EVR-Tuiasi/Shield_VCU_Invertoare/2.Datasheet/Sketch.jpg

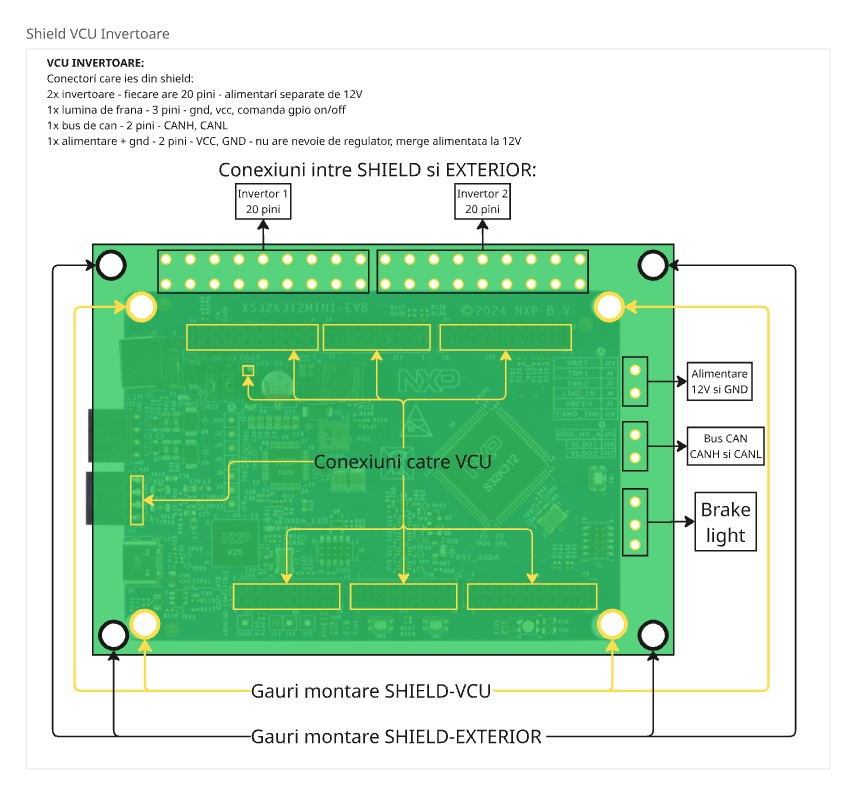
2.Datasheet/Sketch.jpg
