EVR-Tuiasi/Shield_VCU_Invertoare/2.Datasheet/Inverter/InvertorPinout.jpg

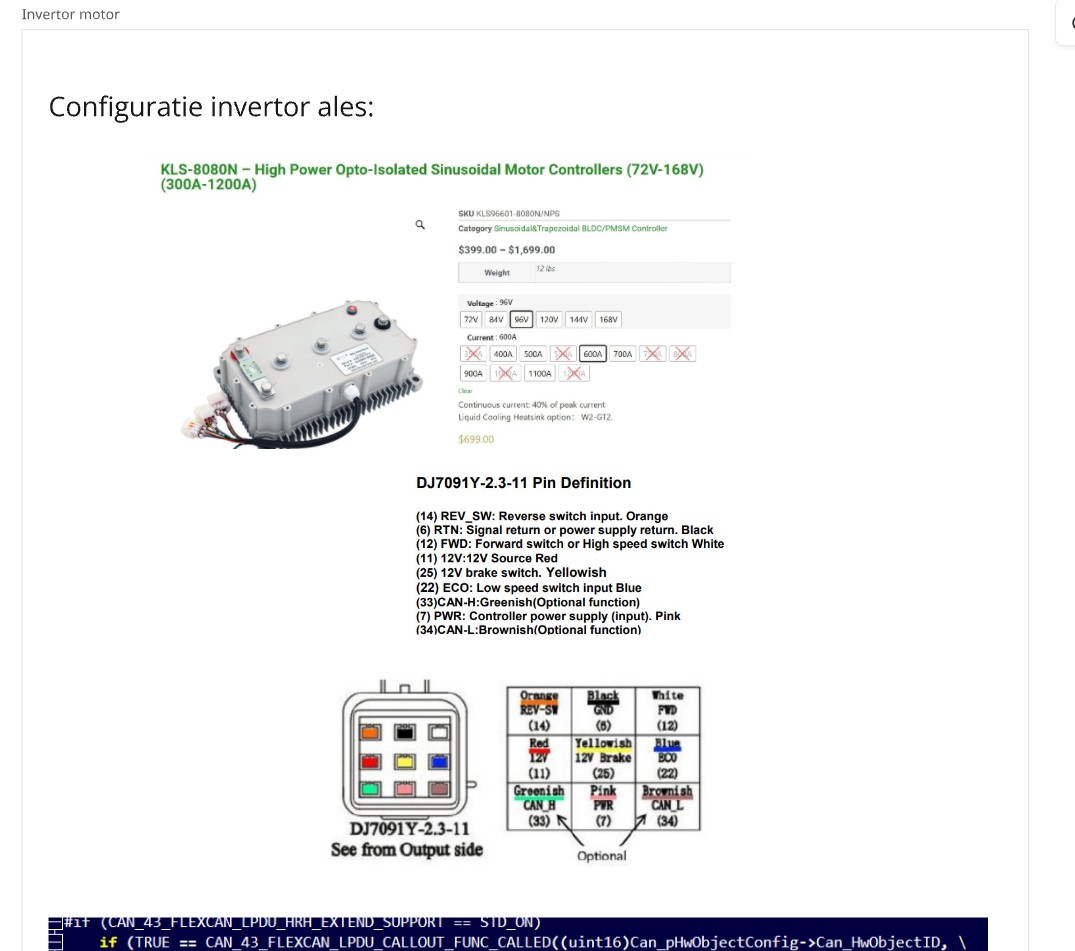
2.Datasheet/Inverter/InvertorPinout.jpg
