EVR-Tuiasi/Shield_VCU_Invertoare/4.Simulations/FAN_ctrl_HIGH.png

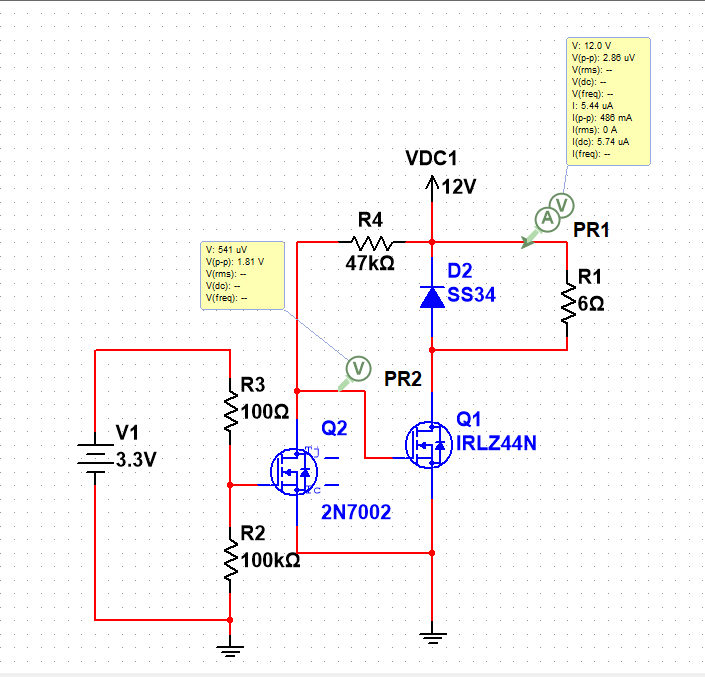
4.Simulations/FAN_ctrl_HIGH.png
