EVR-Tuiasi/Shield_VCU_Invertoare/4.Simulations/fan_cTRL_low.png

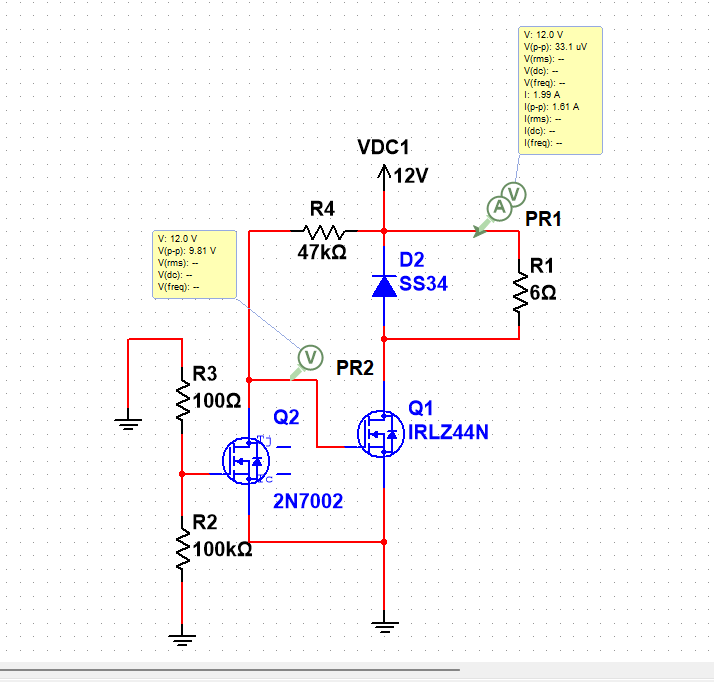
4.Simulations/fan_cTRL_low.png
