EVR-Tuiasi/Shield_VCU_Invertoare/4.Simulations/IRLZ44N_3Amp_LOAD.png

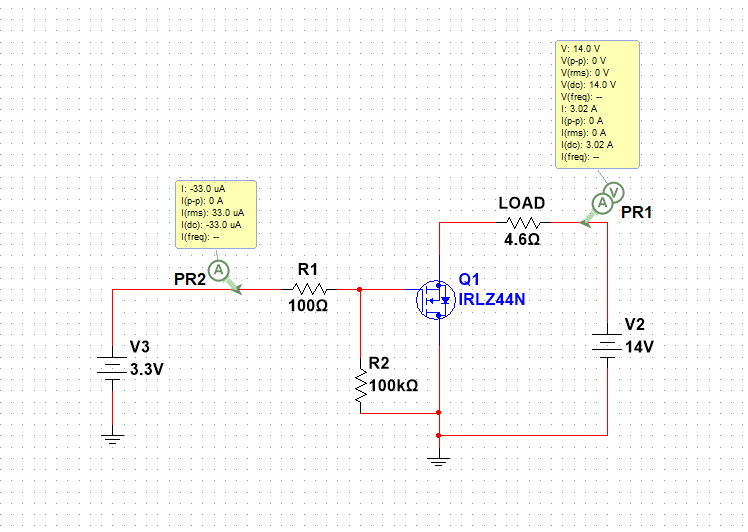
4.Simulations/IRLZ44N_3Amp_LOAD.png
