EVR-Tuiasi/Shield_VCU_Invertoare/4.Simulations/NI_relay.jpg

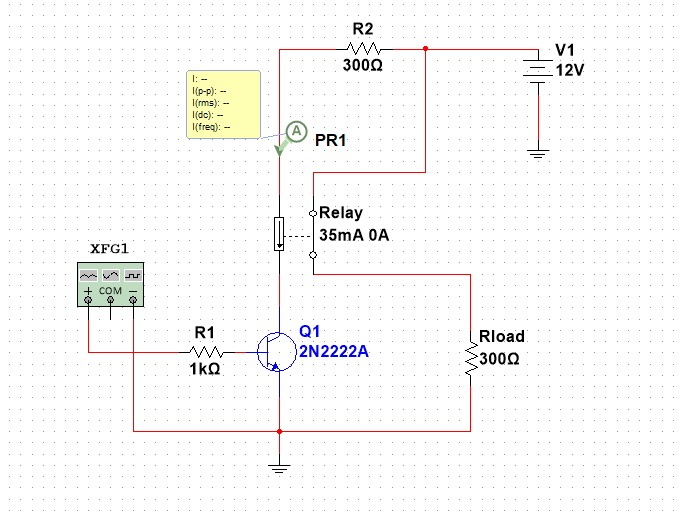
4.Simulations/NI_relay.jpg
