EVR-Tuiasi/Shield_VCU_Invertoare/4.Simulations/Screenshot 2026-03-28 124655.jpg

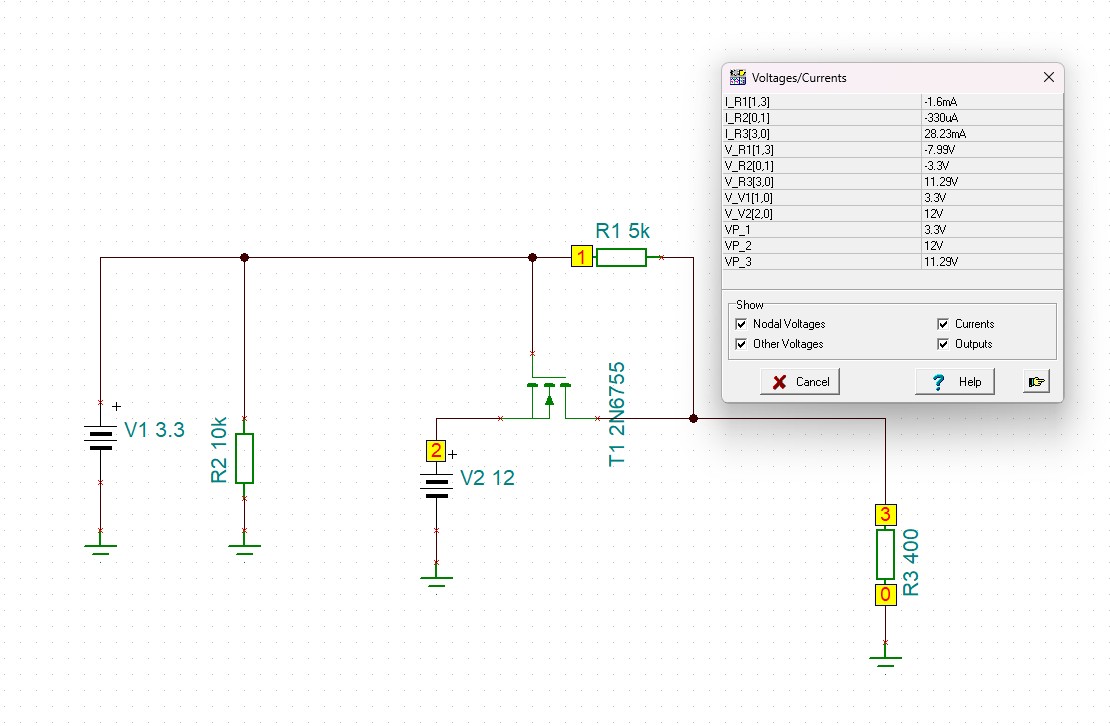
4.Simulations/Screenshot 2026-03-28 124655.jpg
