EVR-Tuiasi/Shield_VCU_Invertoare/3.BOM_files/BOM_VCUinvertor.csv

Reference | Qty | Value | Footprint | Part Number | Manufacturer
U5,U6,U7,U8 | 4 | MIC4416 BM4 | Package_TO_SOT_SMD:SOT-143_Handsoldering | MIC4416YM4-TR | Microchip Technology
U3 | 1 | TLV76150DCY | Package_TO_SOT_SMD:SOT-223-3_TabPin2 | TLV76150DCYR | Texas Instruments
U1 | 1 | TJA1448AT | TJA1448:NXP-TJA1448A_NXP | TJA1448AT/0Z | NXP Semiconductors
R31, R52,R53,R54,R55,R56,R57,R58,R59,R60,R61 | 11 | 100R | Resistor_SMD:R_1206_3216Metric_Pad1.30x1.75mm_HandSolder | CRCW1206100RFKEC | Vishay
R29 | 1 | 1k | Resistor_SMD:R_1206_3216Metric_Pad1.30x1.75mm_HandSolder | CRCW12061K00FKEAC | Vishay
R6,R8,R10,R12,R13,R14,R16,R18,R20,R21,R22,R64,R62,R65 | 14 | 10k | Resistor_SMD:R_1206_3216Metric_Pad1.30x1.75mm_HandSolder | CRCW120610K0JNEAHP | Vishay
R5,R7,R9,R11,R15,R17,R19,R23,R24,R63 | 10 | 100k | Resistor_SMD:R_1206_3216Metric_Pad1.30x1.75mm_HandSolder | CRCW1206100KFKEBC | Vishay
R1,R2,R3,R4 | 4 | 60R4 | Resistor_SMD:R_1206_3216Metric_Pad1.30x1.75mm_HandSolder | CRCW120660R4FKEA | Vishay
Q21,Q22,Q23,Q24 | 4 | IRLZ44N | Package_TO_SOT_THT:TO-220-3_Vertical | IRLZ44NPBF | Infineon Technologies
Q1,Q2,Q3,Q4,Q5,Q6,Q7,Q8,Q9,Q10,Q11 | 11 | 2N7002 | Package_TO_SOT_SMD:SOT-23 | 2N7002 | Diotec Semiconductor
K1 | 1 | IM06DGR | Library_GHST:Relay_IM06DGR | IM06DGR | TE Connectivity
DAC1 | 1 | LTC2645HMS-L12_PBF | LTC2645HMS-L12_PBF:MSOP-16_MS | LTC2645CMS-L12#PBF | Analog Devices Inc.
D11,D13,D14,D15,D16 | 5 | SS34 | Diode_SMD:D_SMA | SK32SMA | Diotec Semiconductor
D2 | 1 | MBRS340 | Diode_SMD:D_SMC | SSC54HE3_A/H | Vishay Semiconductors
D1 | 1 | MBR0540 | Diode_SMD:D_SOD-123 | MBR0540T1G | onsemi
C9 | 1 | 10uF | Capacitor_SMD:C_1206_3216Metric_Pad1.33x1.80mm_HandSolder | C1206C106K4RAC7210 | KEMET
C7,C8,C15,C17,C19,C21 | 6 | 4.7uF | Capacitor_SMD:C_1206_3216Metric_Pad1.33x1.80mm_HandSolder | CC1206KFX7R9BB475 | YAGEO
C4 | 1 | 2.2uF | Capacitor_SMD:C_1206_3216Metric_Pad1.33x1.80mm_HandSolder | C1206C225K5RECAUTO7210 | KEMET
C1,C3,C5,C6,C10,C16,C18,C20,C22 | 9 | 0.1uF | Capacitor_SMD:C_1206_3216Metric_Pad1.33x1.80mm_HandSolder | VJ1206Y104KXXPW1BC | Vishay/Vitramon
