EVR-Tuiasi/Shield_VCU_Invertoare/2.Datasheet/CAN/NXP-TJA1448A_NXP.step

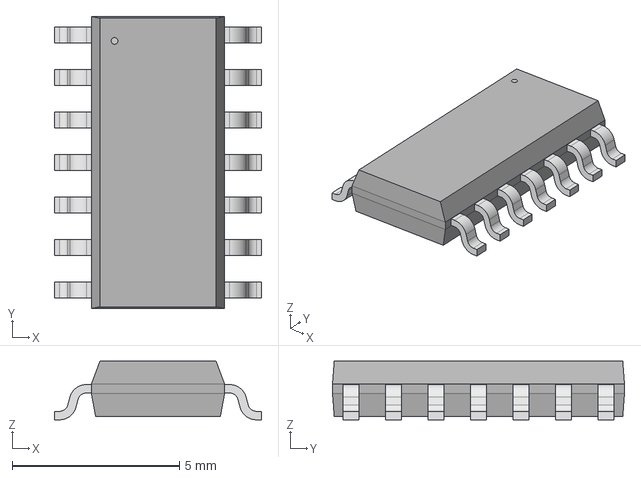
[picture p8: CAD file, 2026-06-21]
2.Datasheet/CAN/NXP-TJA1448A_NXP.step
6.20 x 8.74 x 1.75 mm
