EVR-Tuiasi/Shield_VCU_Invertoare/2.Datasheet/LTC2645HMS-L12_PBF/LTC2645HMS-L12_PBF.step

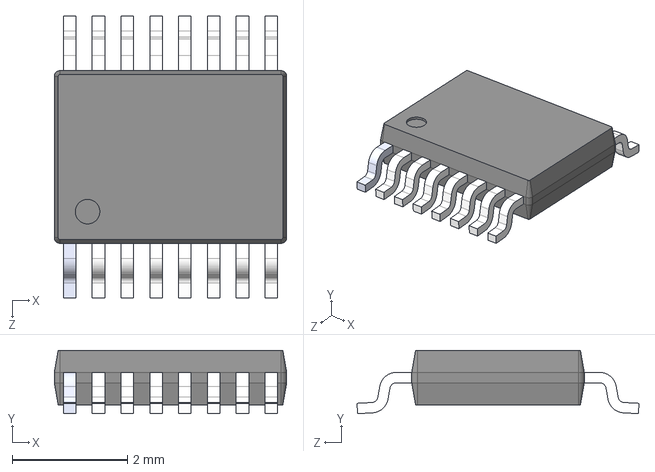
[picture p9: CAD file, 2026-03-26]
2.Datasheet/LTC2645HMS-L12_PBF/LTC2645HMS-L12_PBF.step
4.04 x 1.10 x 4.90 mm
