EVR-Tuiasi/Shield_VCU_Invertoare/6.STEP/INV_FAN_2.0.step

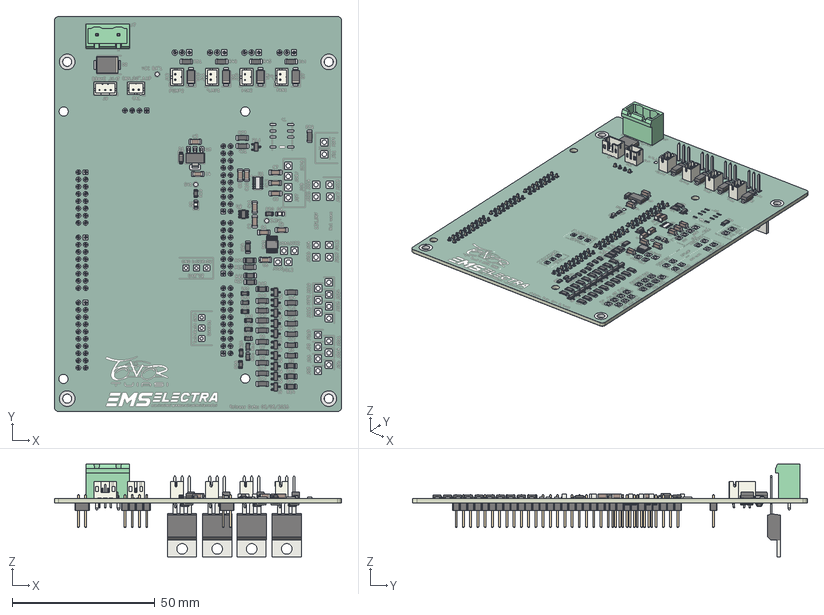
[picture p10: CAD file, 2026-06-06]
6.STEP/INV_FAN_2.0.step
100.7 x 138.5 x 32.5 mm
JST_PH_B3B-PH-K_1x03_P2.00mm_Vertical
JST_PH_B2B-PH-K_1x02_P2.00mm_Vertical x 5
R_0805_2012Metric x 12
R_1206_3216Metric x 44
LED_0805_2012Metric x 2
C_1206_3216Metric x 12
D_SMA x 4
SOT-23 x 15
SOT-23-6
PhoenixContact_GMSTBVA_2,5_2-G-7,62_1x02_P7.62mm_Vertical
SOT-223
D_SMC
D_SOD-123
LTC2645HMS-L12_PBF
TO-220-3_Vertical x 4
PinHeader_2x08_P2.54mm_Vertical x 3
PinHeader_1x04_P2.54mm_Vertical
PinHeader_2x10_P2.54mm_Vertical x 3
VCUinvertor_copper
VCUinvertor_pad
VCUinvertor_via
VCUinvertor_silkscreen x 2
VCUinvertor_soldermask x 2
VCUinvertor_PCB
