EVR-Tuiasi/Shield_VCU_Invertoare/6.STEP/Shield_INV_FAN_PUMP.step

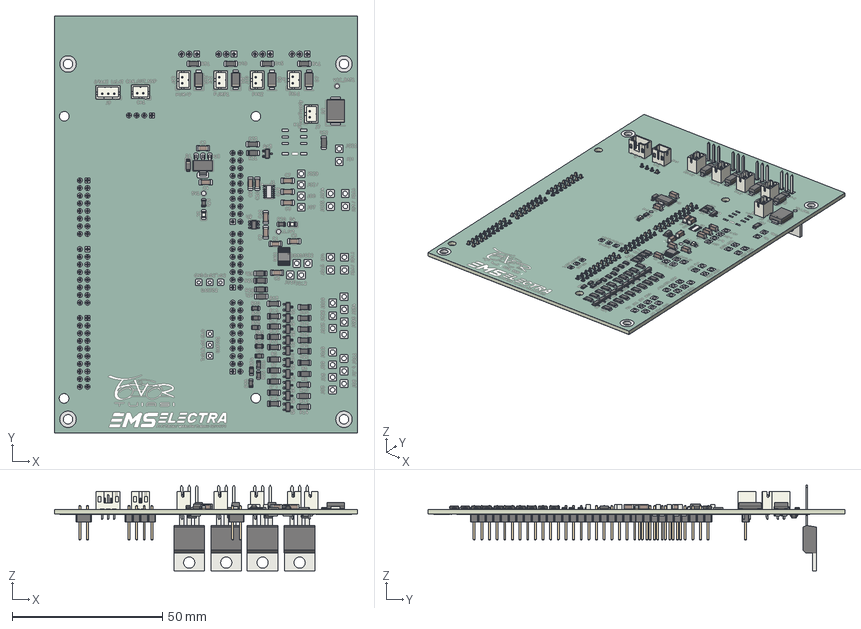
[picture p11: CAD file, 2026-06-04]
6.STEP/Shield_INV_FAN_PUMP.step
100.7 x 138.5 x 28.5 mm
JST_PH_B3B-PH-K_1x03_P2.00mm_Vertical
JST_PH_B2B-PH-K_1x02_P2.00mm_Vertical x 6
R_0805_2012Metric x 12
R_1206_3216Metric x 43
LED_0805_2012Metric x 2
C_1206_3216Metric x 12
D_SMA x 4
SOT-23 x 15
SOT-23-6
SOT-223
D_SMC
D_SOD-123
LTC2645HMS-L12_PBF
TO-220-3_Vertical x 4
PinHeader_2x08_P2.54mm_Vertical x 3
PinHeader_1x04_P2.54mm_Vertical
PinHeader_2x10_P2.54mm_Vertical x 3
VCUinvertor_copper
VCUinvertor_pad
VCUinvertor_via
VCUinvertor_silkscreen x 2
VCUinvertor_soldermask x 2
VCUinvertor_PCB
