EVR-Tuiasi/Shield_VCU_Invertoare/6.STEP/Shield_INV_NO_FAN.step

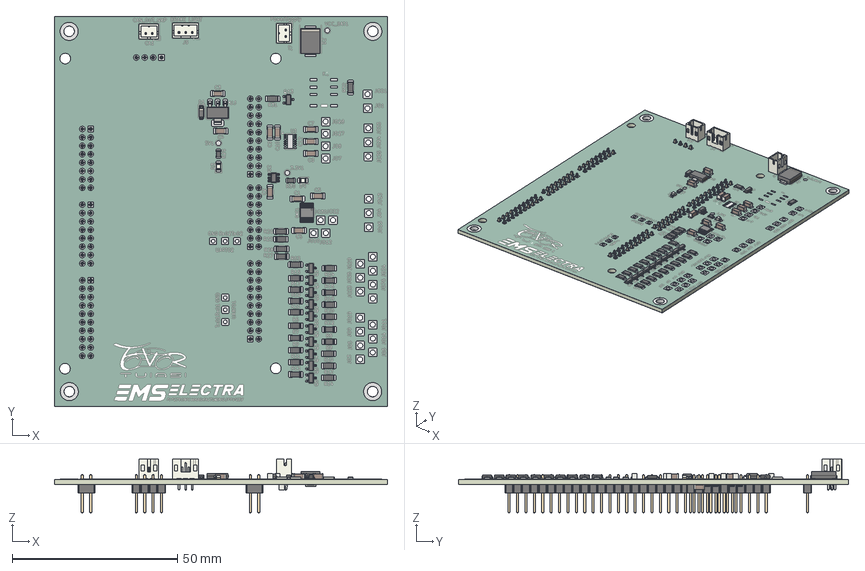
[picture p12: CAD file, 2026-05-14]
6.STEP/Shield_INV_NO_FAN.step
100.7 x 117.9 x 16.2 mm
JST_PH_B3B-PH-K_1x03_P2.00mm_Vertical
LED_0805_2012Metric x 2
C_1206_3216Metric x 12
R_1206_3216Metric x 30
SOT-23 x 11
SOT-23-6
JST_PH_B2B-PH-K_1x02_P2.00mm_Vertical x 2
SOT-223
D_SMC
D_SOD-123
R_0805_2012Metric x 2
LTC2645HMS-L12_PBF
PinHeader_2x08_P2.54mm_Vertical x 3
PinHeader_1x04_P2.54mm_Vertical
PinHeader_2x10_P2.54mm_Vertical x 3
VCUinvertor_copper
VCUinvertor_pad
VCUinvertor_via
VCUinvertor_silkscreen x 2
VCUinvertor_soldermask x 2
VCUinvertor_PCB
