EVR-Tuiasi/Shield_VCU_Invertoare/7.Prototype/Tested.png

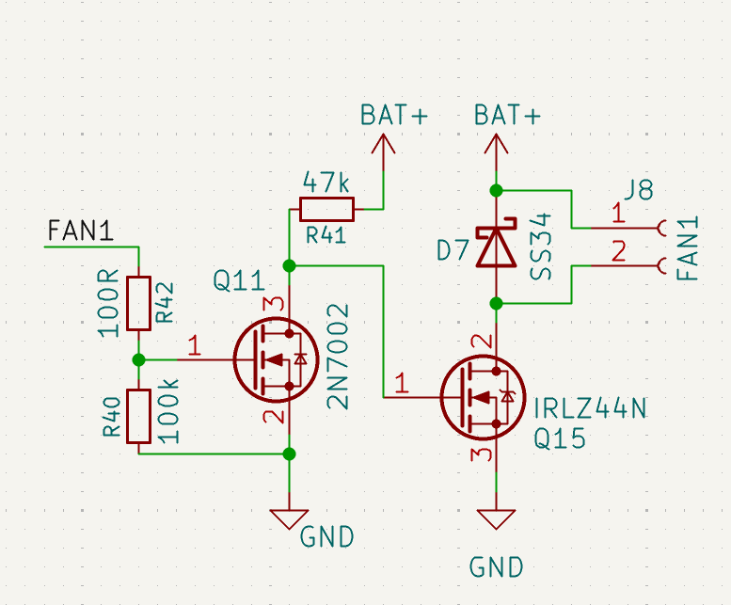
7.Prototype/Tested.png
