EVR-Tuiasi/Shield_VCU_Invertoare/(list of files, drawings)

Other design files:
4.Simulations/FANPUMPctrl.ms14
4.Simulations/FANPUMPCtrl/Design1.ms14
4.Simulations/Relay+BJT.ms14
