EVR-Tuiasi/Shield_VCU_Invertoare/1.INV_KiCAD/VCUinvertor.kicad_pcb

## KiCad design 1.INV_KiCAD/VCUinvertor.kicad_pcb (2026-06-29)

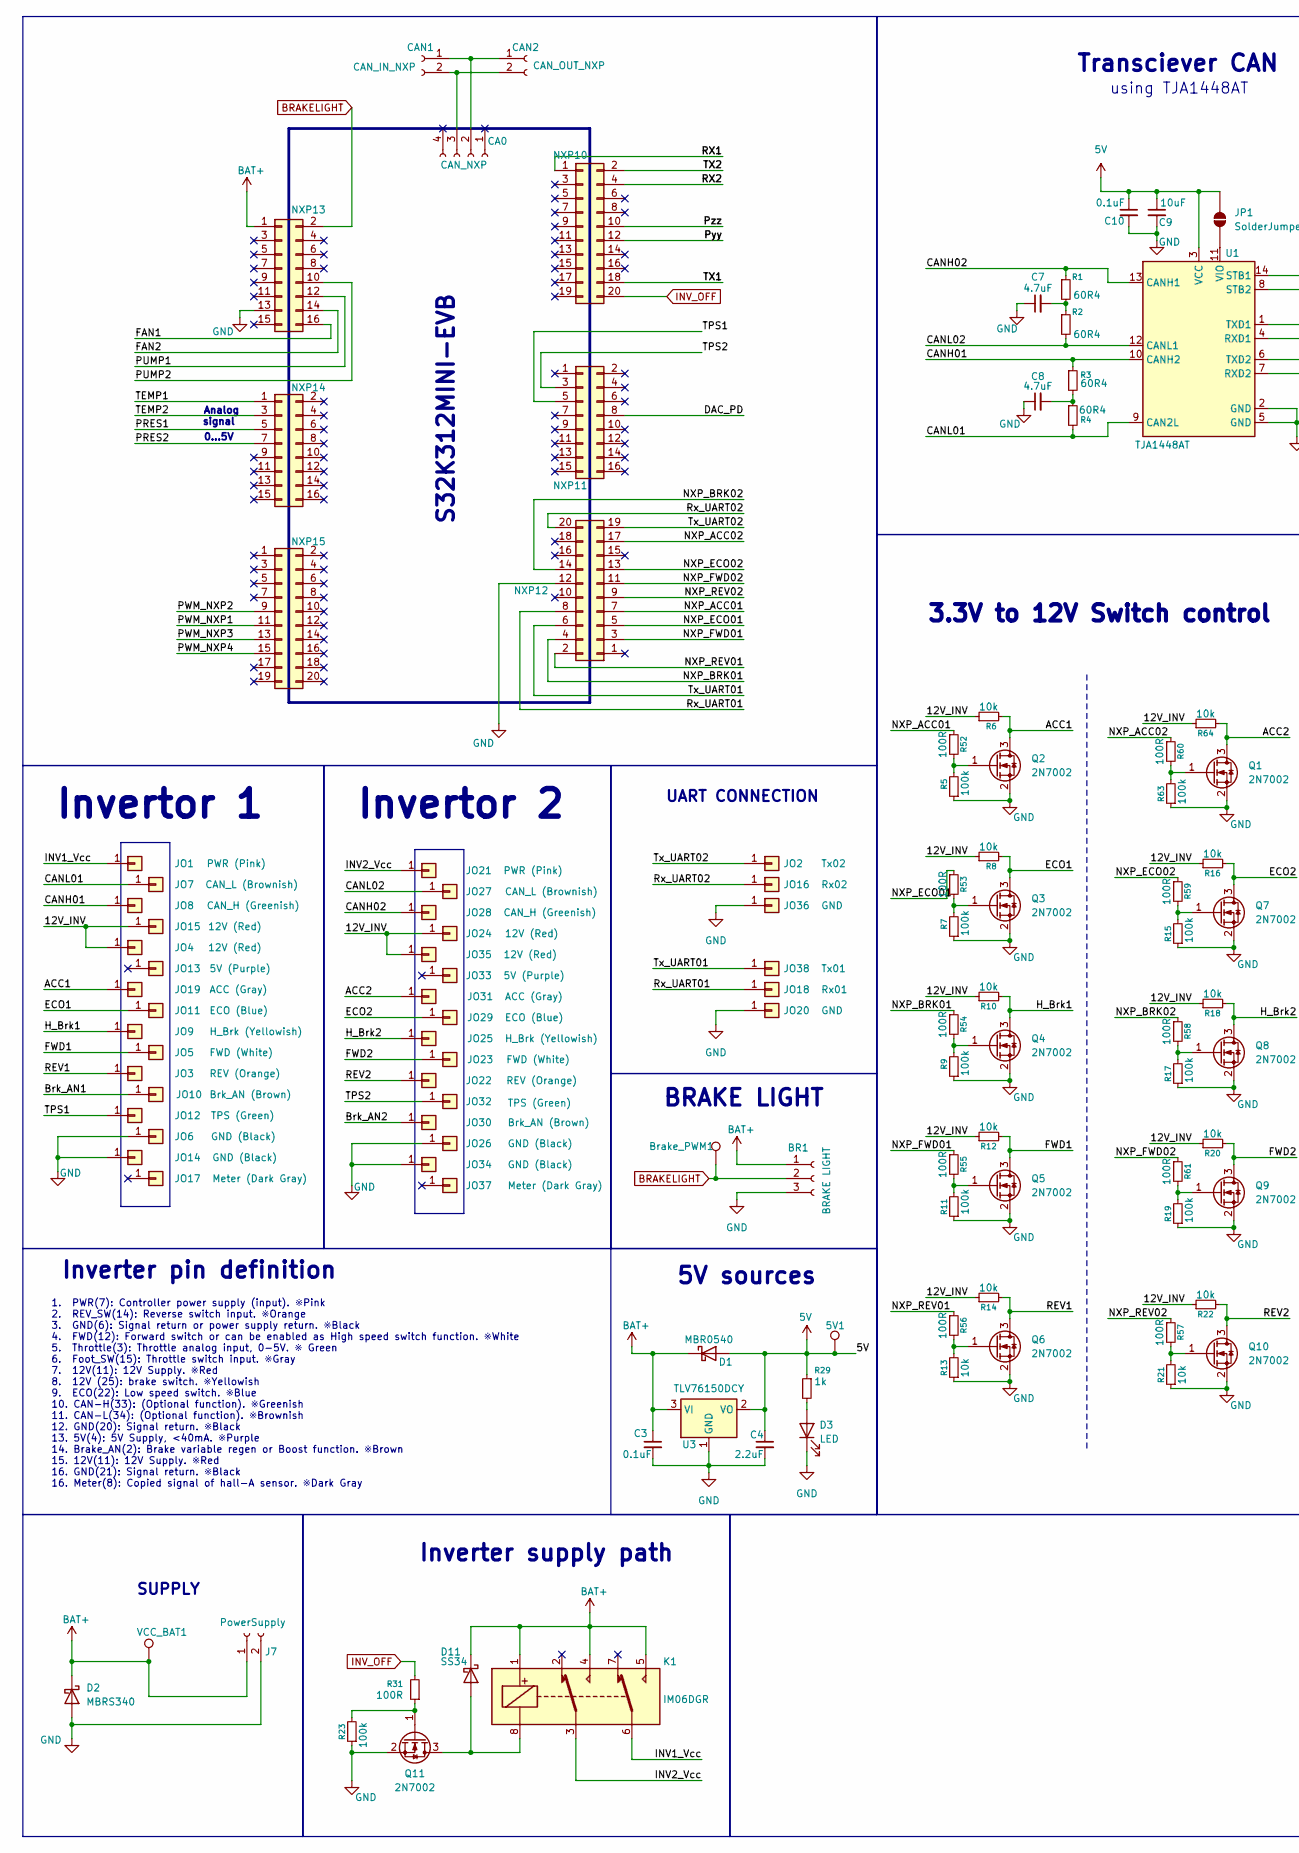
[picture p14: schematic VCUinvertor.kicad_sch, Shield Invertoare - STEPULEAC GHEORGHE, part in row 1, column 1]

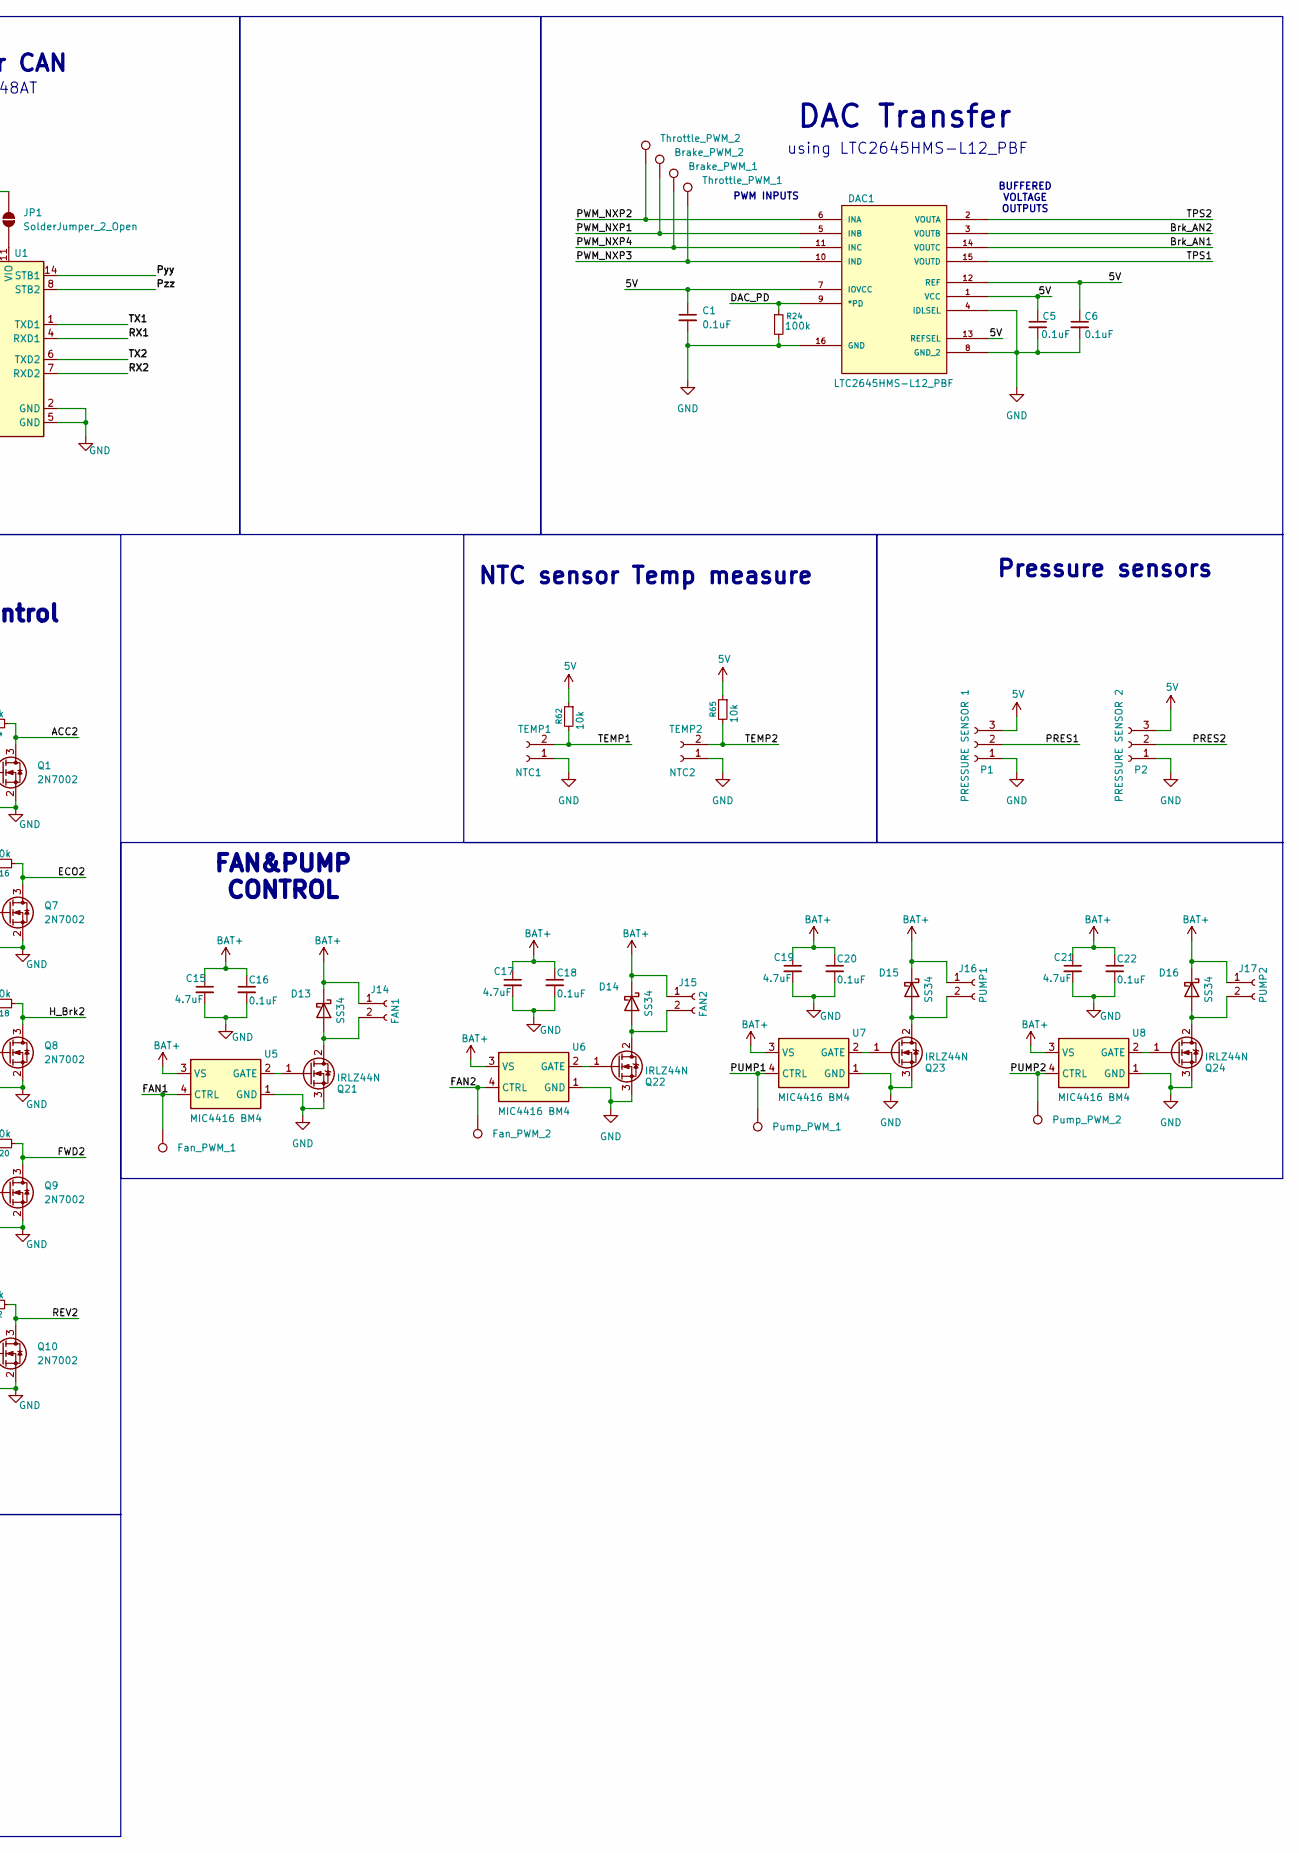
[picture p15: schematic VCUinvertor.kicad_sch, Shield Invertoare - STEPULEAC GHEORGHE, part in row 1, column 2]

Parts:
5V1: 5V; TestPoint_Pad_D1.5mm
BR1: BRAKE LIGHT; JST_XH_B3B-XH-A_1x03_P2.50mm_Vertical
Brake_PWM1: TestPoint; TestPoint_Pad_D1.5mm
Brake_PWM_1, Brake_PWM_2: TestPoint; TestPoint_Pad_D1.5mm
C1, C3, C5, C6, C10, C16, C18, C20, C22: 0.1uF; C_1206_3216Metric_Pad1.33x1.80mm_HandSolder
C4: 2.2uF; C_1206_3216Metric_Pad1.33x1.80mm_HandSolder
C7, C8, C15, C17, C19, C21: 4.7uF; C_1206_3216Metric_Pad1.33x1.80mm_HandSolder
C9: 10uF; C_1206_3216Metric_Pad1.33x1.80mm_HandSolder
CA0: CAN_NXP; PinHeader_1x04_P2.54mm_Vertical
CAN1: CAN_IN_NXP; JST_PH_B2B-PH-K_1x02_P2.00mm_Vertical
CAN2: CAN_OUT_NXP; JST_PH_B2B-PH-K_1x02_P2.00mm_Vertical
D1: MBR0540; D_SOD-123
D2: MBRS340; D_SMC
D3: LED; LED_0805_2012Metric_Pad1.15x1.40mm_HandSolder
D11, D13, D14, D15, D16: SS34; D_SMA
DAC1: LTC2645HMS-L12_PBF; MSOP-16_MS; MANUFACTURER_PART_NUMBER ltc2645imsl8#pbf
Fan_PWM_1, Fan_PWM_2: TestPoint; TestPoint_Pad_D1.5mm
J7: PowerSupply; PhoenixContact_GMSTBVA_2,5_2-G-7,62_1x02_P7.62mm_Vertical
J14: FAN1; JST_XH_B2B-XH-A_1x02_P2.50mm_Vertical
J15: FAN2; JST_XH_B2B-XH-A_1x02_P2.50mm_Vertical
J16: PUMP1; JST_XH_B2B-XH-A_1x02_P2.50mm_Vertical
J17: PUMP2; JST_XH_B2B-XH-A_1x02_P2.50mm_Vertical
JO1, JO21: PWR (Pink); SolderWire-0.75sqmm_1x01_D1.25mm_OD2.3mm
JO2: Tx02; SolderWire-0.5sqmm_1x01_D0.9mm_OD2.1mm
JO3, JO22: REV (Orange); SolderWire-0.75sqmm_1x01_D1.25mm_OD2.3mm
JO4, JO15, JO24, JO35: 12V (Red); SolderWire-0.75sqmm_1x01_D1.25mm_OD2.3mm
JO5, JO23: FWD (White); SolderWire-0.75sqmm_1x01_D1.25mm_OD2.3mm
JO6, JO14, JO26, JO34: GND (Black); SolderWire-0.75sqmm_1x01_D1.25mm_OD2.3mm
JO7, JO27: CAN_L (Brownish); SolderWire-0.75sqmm_1x01_D1.25mm_OD2.3mm
JO8, JO28: CAN_H (Greenish); SolderWire-0.75sqmm_1x01_D1.25mm_OD2.3mm
JO9, JO25: H_Brk (Yellowish); SolderWire-0.75sqmm_1x01_D1.25mm_OD2.3mm
JO10, JO30: Brk_AN (Brown); SolderWire-0.75sqmm_1x01_D1.25mm_OD2.3mm
JO11, JO29: ECO (Blue); SolderWire-0.75sqmm_1x01_D1.25mm_OD2.3mm
JO12, JO32: TPS (Green); SolderWire-0.75sqmm_1x01_D1.25mm_OD2.3mm
JO13, JO33: 5V (Purple); SolderWire-0.75sqmm_1x01_D1.25mm_OD2.3mm
JO16: Rx02; SolderWire-0.5sqmm_1x01_D0.9mm_OD2.1mm
JO17, JO37: Meter (Dark Gray); SolderWire-0.75sqmm_1x01_D1.25mm_OD2.3mm
JO18: Rx01; SolderWire-0.5sqmm_1x01_D0.9mm_OD2.1mm
JO19, JO31: ACC (Gray); SolderWire-0.75sqmm_1x01_D1.25mm_OD2.3mm
JO20, JO36: GND; SolderWire-0.5sqmm_1x01_D0.9mm_OD2.1mm
JO38: Tx01; SolderWire-0.5sqmm_1x01_D0.9mm_OD2.1mm
JP1: SolderJumper_2_Open; SolderJumper-2_P1.3mm_Open_RoundedPad1.0x1.5mm
K1: IM06DGR; Relay_IM06DGR
NXP10: NXP10; PinHeader_2x10_P2.54mm_Vertical
NXP11: NXP11; PinHeader_2x08_P2.54mm_Vertical
NXP12: NXP12; PinHeader_2x10_P2.54mm_Vertical
NXP13: NXP13; PinHeader_2x08_P2.54mm_Vertical
NXP14: NXP14; PinHeader_2x08_P2.54mm_Vertical
NXP15: NXP15; PinHeader_2x10_P2.54mm_Vertical
P1: PRESSURE SENSOR 1; JST_PH_B3B-PH-K_1x03_P2.00mm_Vertical
P2: PRESSURE SENSOR 2; JST_PH_B3B-PH-K_1x03_P2.00mm_Vertical
Pump_PWM_1, Pump_PWM_2: TestPoint; TestPoint_Pad_D1.5mm
Q1, Q2, Q3, Q4, Q5, Q6, Q7, Q8, Q9, Q10, Q11: 2N7002; SOT-23
Q21, Q22, Q23, Q24: IRLZ44N; TO-220-3_Vertical
R1, R2, R3, R4: 60R4; R_1206_3216Metric_Pad1.30x1.75mm_HandSolder
R5, R7, R9, R11, R15, R17, R19, R23, R24, R63: 100k; R_1206_3216Metric_Pad1.30x1.75mm_HandSolder
R6, R8, R10, R12, R13, R14, R16, R18, R20, R21, R22, R62, R64, R65: 10k; R_1206_3216Metric_Pad1.30x1.75mm_HandSolder
R29: 1k; R_1206_3216Metric_Pad1.30x1.75mm_HandSolder
R31, R52, R53, R54, R55, R56, R57, R58, R59, R60, R61: 100R; R_1206_3216Metric_Pad1.30x1.75mm_HandSolder
TEMP1: NTC1; JST_PH_B2B-PH-K_1x02_P2.00mm_Vertical
TEMP2: NTC2; JST_PH_B2B-PH-K_1x02_P2.00mm_Vertical
Throttle_PWM_1, Throttle_PWM_2: TestPoint; TestPoint_Pad_D1.5mm
U1: TJA1448AT; NXP-TJA1448A_NXP
U3: TLV76150DCY; SOT-223-3_TabPin2
U5, U6, U7, U8: MIC4416 BM4; SOT-143_Handsoldering
VCC_BAT1: 12V; TestPoint_Pad_D1.5mm

Connections:
5V: 5V1.1 (1_1), C1.1, C4.1, C5.1, C6.1, C9.1, C10.1, D1.2 (A), DAC1.1 (VCC), DAC1.7 (IOVCC), DAC1.12 (REF), DAC1.13 (REFSEL), JP1.2 (B), P1.3, P2.3, R29.1, R62.1, R65.1, U1.3 (VCC), U3.2 (VO)
/12V_INV: JO4.1 (Pin_1_1), JO15.1 (Pin_1_1), JO24.1 (Pin_1_1), JO35.1 (Pin_1_1), R6.1, R8.1, R10.1, R12.1, R14.1, R16.1, R18.1, R20.1, R22.1, R64.1
/ACC1: JO19.1 (Pin_1_1), Q2.3 (D), R6.2
/ACC2: JO31.1 (Pin_1_1), Q1.3 (D), R64.2
/Brk_AN1: DAC1.14 (VOUTC), JO10.1 (Pin_1_1)
/Brk_AN2: DAC1.3 (VOUTB), JO30.1 (Pin_1_1)
/CANH01: JO8.1 (Pin_1_1), R3.1, U1.10 (CANH2)
/CANH02: JO28.1 (Pin_1_1), R1.1, U1.13 (CANH1)
/CANL01: JO7.1 (Pin_1_1), R4.2, U1.9 (CAN2L)
/CANL02: JO27.1 (Pin_1_1), R2.2, U1.12 (CANL1)
/DAC_PD: DAC1.9 (*PD), NXP11.8, R24.1
/ECO1: JO11.1 (Pin_1_1), Q3.3 (D), R8.2
/ECO2: JO29.1 (Pin_1_1), Q7.3 (D), R16.2
/FAN1: Fan_PWM_1.1 (1_1), NXP13.16, U5.4 (CTRL)
/FAN2: Fan_PWM_2.1 (1_1), NXP13.14, U6.4 (CTRL)
/FWD1: JO5.1 (Pin_1_1), Q5.3 (D), R12.2
/FWD2: JO23.1 (Pin_1_1), Q9.3 (D), R20.2
/H_Brk1: JO9.1 (Pin_1_1), Q4.3 (D), R10.2
/H_Brk2: JO25.1 (Pin_1_1), Q8.3 (D), R18.2
/INV1_Vcc: JO1.1 (Pin_1_1), K1.6
/INV2_Vcc: JO21.1 (Pin_1_1), K1.3
/NXP_ACC01: NXP12.7, R52.1
/NXP_ACC02: NXP12.17, R60.1
/NXP_BRK01: NXP12.4, R54.1
/NXP_BRK02: NXP12.14, R58.1
/NXP_ECO01: NXP12.5, R53.1
/NXP_ECO02: NXP12.13, R59.1
/NXP_FWD01: NXP12.3, R55.1
/NXP_FWD02: NXP12.11, R61.1
/NXP_REV01: NXP12.2, R56.1
/NXP_REV02: NXP12.9, R57.1
/PRES1: NXP14.5, P1.2
/PRES2: NXP14.7, P2.2
/PUMP1: NXP13.12, Pump_PWM_1.1 (1_1), U7.4 (CTRL)
/PUMP2: NXP13.10, Pump_PWM_2.1 (1_1), U8.4 (CTRL)
/PWM_NXP1: Brake_PWM_2.1 (1_1), DAC1.5 (INB), NXP15.11
/PWM_NXP2: DAC1.6 (INA), NXP15.9, Throttle_PWM_2.1 (1_1)
/PWM_NXP3: DAC1.10 (IND), NXP15.13, Throttle_PWM_1.1 (1_1)
/PWM_NXP4: Brake_PWM_1.1 (1_1), DAC1.11 (INC), NXP15.15
/Pyy: NXP10.12, U1.14 (STB1)
/Pzz: NXP10.10, U1.8 (STB2)
/REV1: JO3.1 (Pin_1_1), Q6.3 (D), R14.2
/REV2: JO22.1 (Pin_1_1), Q10.3 (D), R22.2
/RX1: NXP10.1, U1.4 (RXD1)
/RX2: NXP10.4, U1.7 (RXD2)
/Rx_UART01: JO18.1 (Pin_1_1), NXP12.8
/Rx_UART02: JO16.1 (Pin_1_1), NXP12.20
/TEMP1: NXP14.1, R62.2, TEMP1.2
/TEMP2: NXP14.3, R65.2, TEMP2.2
/TPS1: DAC1.15 (VOUTD), JO12.1 (Pin_1_1), NXP11.5
/TPS2: DAC1.2 (VOUTA), JO32.1 (Pin_1_1), NXP11.3
/TX1: NXP10.18, U1.1 (TXD1)
/TX2: NXP10.2, U1.6 (TXD2)
/Tx_UART01: JO38.1 (Pin_1_1), NXP12.6
/Tx_UART02: JO2.1 (Pin_1_1), NXP12.19
BAT+: BR1.1, C3.1, C15.1, C16.1, C17.1, C18.1, C19.1, C20.1, C21.1, C22.1, D1.1 (K), D2.1 (K), D11.1 (K), D13.1 (K), D14.1 (K), D15.1 (K), D16.1 (K), J7.1, J14.1, J15.1, J16.1, J17.1, K1.1, K1.4, K1.5, NXP13.1, U3.3 (VI), U5.3 (VS), U6.3 (VS), U7.3 (VS), U8.3 (VS), VCC_BAT1.1 (1_1)
BRAKELIGHT: BR1.2, Brake_PWM1.1 (1_1), NXP13.2
GND: BR1.3, C1.2, C3.2, C4.2, C5.2, C6.2, C7.1, C8.1, C9.2, C10.2, C15.2, C16.2, C17.2, C18.2, C19.2, C20.2, C21.2, C22.2, D2.2 (A), D3.1 (K), DAC1.4 (IDLSEL), DAC1.8 (GND_2), DAC1.16 (GND), J7.2, JO6.1 (Pin_1_1), JO14.1 (Pin_1_1), JO20.1 (Pin_1_1), JO26.1 (Pin_1_1), JO34.1 (Pin_1_1), JO36.1 (Pin_1_1), NXP12.12, NXP13.13, P1.1, P2.1, Q1.2 (S), Q2.2 (S), Q3.2 (S), Q4.2 (S), Q5.2 (S), Q6.2 (S), Q7.2 (S), Q8.2 (S), Q9.2 (S), Q10.2 (S), Q11.2 (S), Q21.3 (S), Q22.3 (S), Q23.3 (S), Q24.3 (S), R5.1, R7.1, R9.1, R11.1, R13.1, R15.1, R17.1, R19.1, R21.1, R23.1, R24.2, R63.1, TEMP1.1, TEMP2.1, U1.2 (GND), U1.5 (GND), U3.1 (GND), U5.1 (GND), U6.1 (GND), U7.1 (GND), U8.1 (GND)
INV_OFF: NXP10.20, R31.2
unnamed: C7.2, R1.2, R2.1
unnamed: C8.2, R3.2, R4.1
unnamed: CA0.2, CAN1.1, CAN2.1
unnamed: CA0.3, CAN1.2, CAN2.2
unnamed: D3.2 (A), R29.2
unnamed: D11.2 (A), K1.8, Q11.3 (D)
unnamed: D13.2 (A), J14.2, Q21.2 (D)
unnamed: D14.2 (A), J15.2, Q22.2 (D)
unnamed: D15.2 (A), J16.2, Q23.2 (D)
unnamed: D16.2 (A), J17.2, Q24.2 (D)
unnamed: JP1.1 (A), U1.11 (VIO)
unnamed: Q1.1 (G), R60.2, R63.2
unnamed: Q2.1 (G), R5.2, R52.2
unnamed: Q3.1 (G), R7.2, R53.2
unnamed: Q4.1 (G), R9.2, R54.2
unnamed: Q5.1 (G), R11.2, R55.2
unnamed: Q6.1 (G), R13.2, R56.2
unnamed: Q7.1 (G), R15.2, R59.2
unnamed: Q8.1 (G), R17.2, R58.2
unnamed: Q9.1 (G), R19.2, R61.2
unnamed: Q10.1 (G), R21.2, R57.2
unnamed: Q11.1 (G), R23.2, R31.1
unnamed: Q21.1 (G), U5.2 (GATE)
unnamed: Q22.1 (G), U6.2 (GATE)
unnamed: Q23.1 (G), U7.2 (GATE)
unnamed: Q24.1 (G), U8.2 (GATE)

Notes on the sheet:
Transciever CAN
using LTC2645HMS-L12_PBF
NTC sensor Temp measure
UART CONNECTION
SUPPLY
FAN&PUMP CONTROL
3.3V to 12V Switch control
PWM INPUTS
BUFFERED VOLTAGE OUTPUTS
0...5V
Invertor 1
S32K312MINI-EVB
1. PWR(7): Controller power supply (input). ※Pink 2. REV_SW(14): Reverse switch input. ※Orange 3. GND(6): Signal return or power supply return. ※Black 4. FWD(12): Forward switch or can be enabled as High speed switch function. ※White 5. Throttle(3): Throttle analog input, 0-5V. ※ Green 6. Foot_SW(1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
Analog signal
Inverter supply path
Invertor 2
using TJA1448AT
Pressure sensors
5V sources
DAC Transfer
BRAKE LIGHT
Inverter pin definition

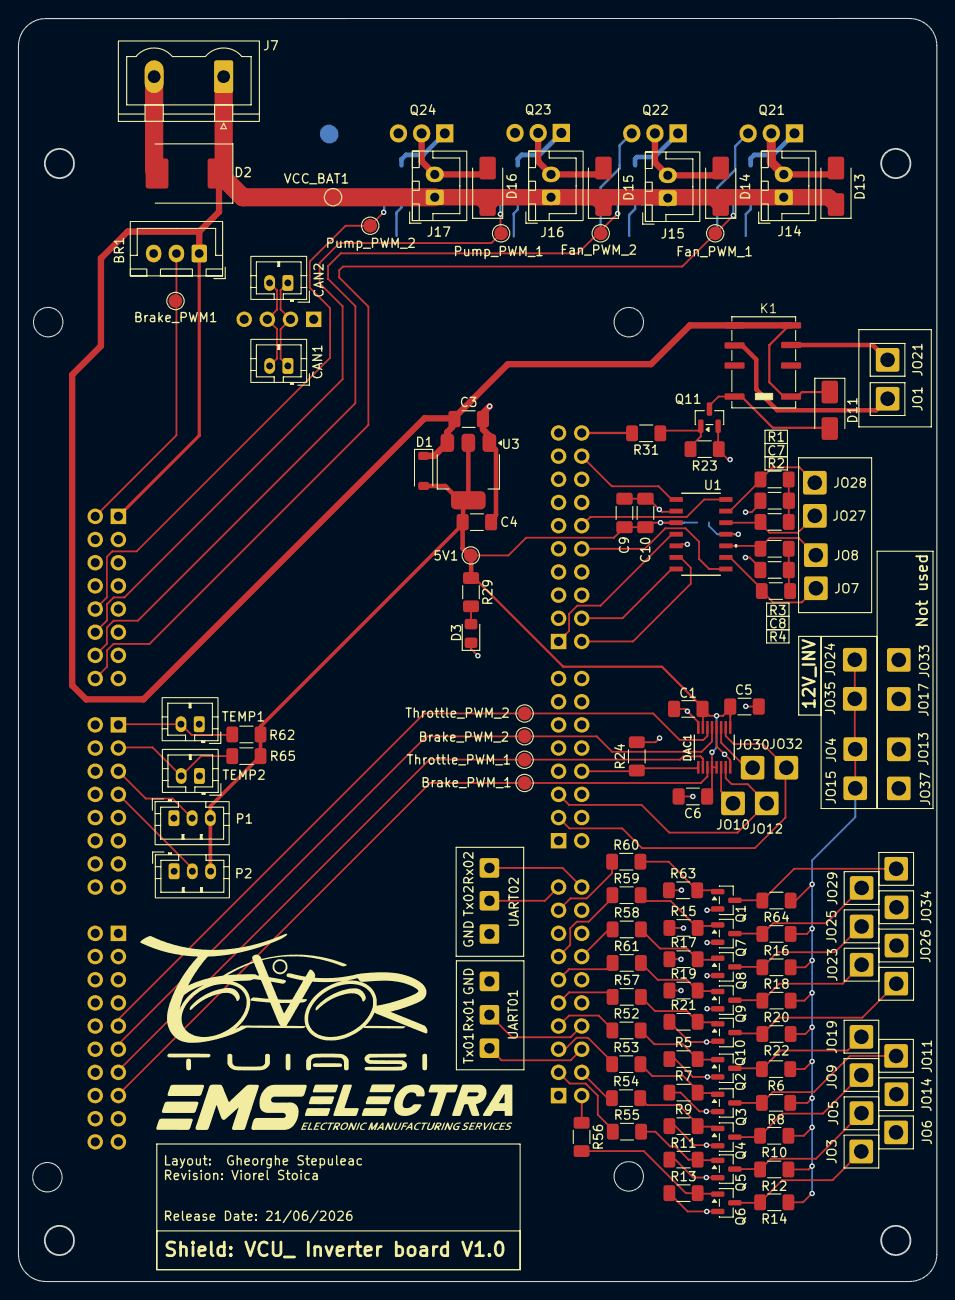
[picture p16: board VCUinvertor.kicad_pcb from above]

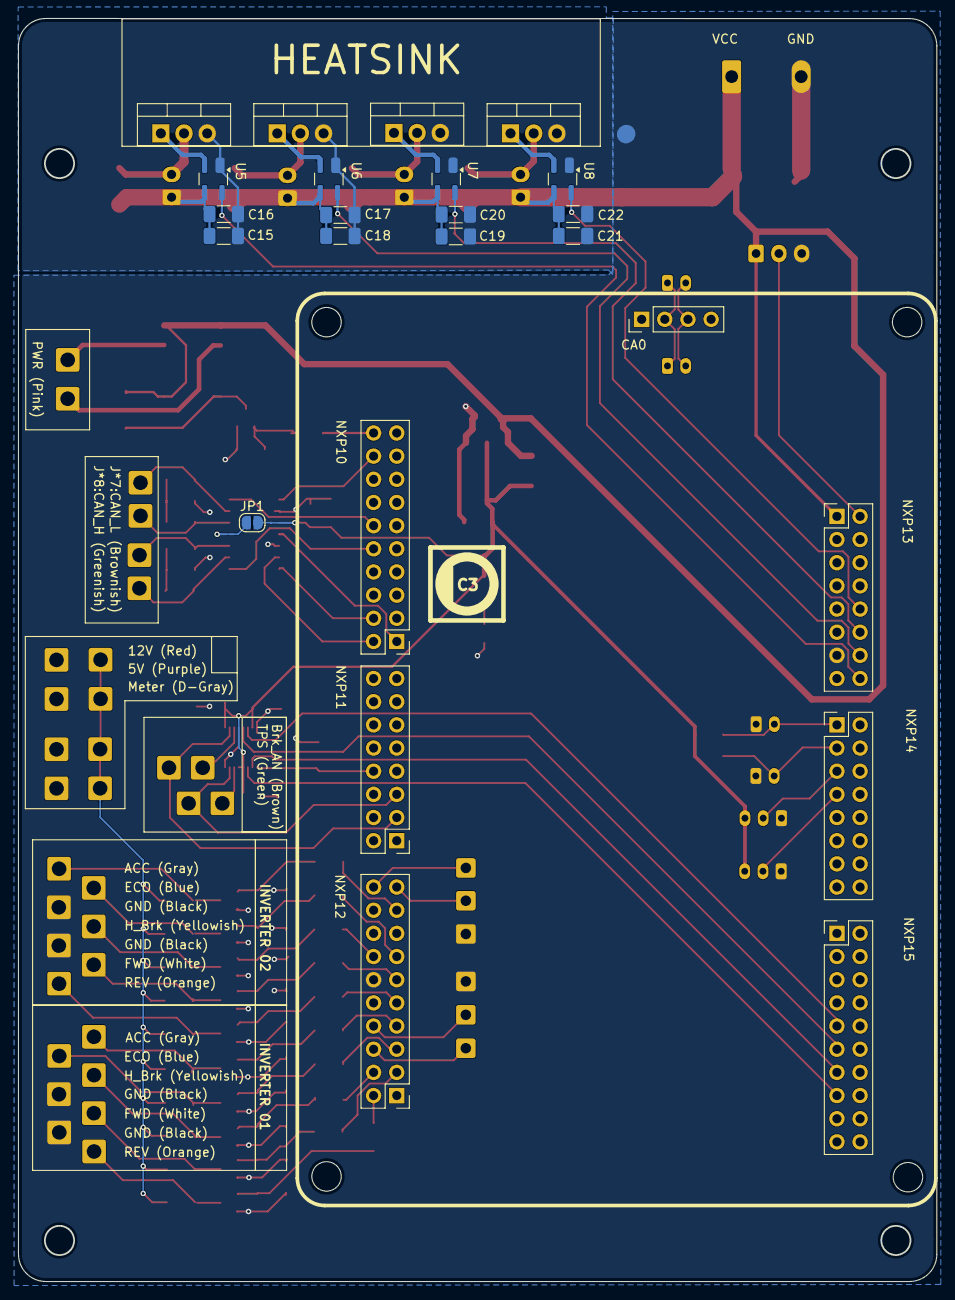
[picture p17: board VCUinvertor.kicad_pcb from below]

Board: 2 copper layers, 100.7 x 138.5 mm, 157 parts (24 on the bottom side), 85 nets.
