EVR-Tuiasi/Shield_VCU_Invertoare/(commit log)

2026-03-26 Scheme added
    [LTC2645HMS-L12_PBF.step, S32K312MINI.kicad_pcb, VCUinvertor.kicad_pcb, VCUinvertor.kicad_sch]
2026-03-28 Footprint assignment
    [VCUinvertor.kicad_pcb, VCUinvertor.kicad_sch]
2026-03-29 Layout_Global arrangement
    [VCUinvertor.kicad_pcb, VCUinvertor.kicad_sch]
2026-03-29 DAQ footprint correction
    [VCUinvertor.kicad_pcb, VCUinvertor.kicad_sch]
2026-03-30 New PMOS config for switching
    [VCUinvertor.kicad_pcb, VCUinvertor.kicad_sch]
2026-03-30 Pin_Assignment_Main_Done
    [15:48, 3/30/2026] Viorel VCU: ptb22 - j12 - pin 1 - LPUART1_TX - UART_INV01 pin 3
    ptb23 - j12 - pin 3 - LPUART1_RX - UART_INV01 pin 2
    ptd2 - j11 - pin 5 - LPUART3_TX - UART_INV02 pin 3
    ptd3 - j11 - pin 7 - LPUART3_RX - UART_INV01 pin 2
    [15:55, 3/30/2026] Viorel VCU: pte23 - j15 - pin 9 - EMIOS1_CH3_H - PWM_NXP1
    pte24 - j15 - pin 11 - EMIOS1_CH4_H - PWM_NXP2
    pte25 - j15 - pin 13 - EMIOS1_CH5_H - PWM_NXP3
    pte26 - j15 - pin 15 - EMIOS1_CH6_H - PWM_NXP4
    [VCUinvertor.kicad_pcb, VCUinvertor.kicad_sch]
2026-03-31 Pyy & Pzz pin assignment
    [VCUinvertor.kicad_sch]
2026-03-31 Added datasheets for MOS
    [VCUinvertor.kicad_pcb, VCUinvertor.kicad_sch]
2026-04-01 Block diagram cleanup
    [VCUinvertor.kicad_pcb, VCUinvertor.kicad_sch]
2026-04-01 BOM csv added
    [VCUinvertor.kicad_pcb, VCUinvertor.kicad_sch, VCUinvertorV1.0.csv]
2026-04-04 Changes on Supply
    1.Protection shottky diode added
    2.Separate supply for INV via Darlington (1A Max.)
    3.Control of the supply from J10 Pin 20 for INV supply - added
    [VCUinvertor.kicad_pcb, VCUinvertor.kicad_sch]
2026-04-04 BOM + Gerbers - added
    [VCUinvertor-B_Cu.gbl, VCUinvertor-B_Mask.gbs, VCUinvertor-B_Paste.gbp, VCUinvertor-B_Silkscreen.gbo, VCUinvertor-Edge_Cuts.gm1, VCUinvertor-F_Cu.gtl, VCUinvertor-F_Mask.gts, VCUinvertor-F_Paste.gtp]
2026-04-06 SMD components resized for Handsoldering (0805 -> 1206)
    *Resistors & Capacitors are now upgraded to size 1206 for easy handsoldering
    [VCUinvertor.kicad_pcb, VCUinvertor.kicad_sch]
2026-04-06 Gerber for bigSMD added
    [VCUinvertor-B_Cu.gbl, VCUinvertor-B_Mask.gbs, VCUinvertor-B_Paste.gbp, VCUinvertor-B_Silkscreen.gbo, VCUinvertor-Edge_Cuts.gm1, VCUinvertor-F_Cu.gtl, VCUinvertor-F_Mask.gts, VCUinvertor-F_Paste.gtp]
2026-04-07 TestPoints added
    [VCUinvertor.kicad_pcb, VCUinvertor.kicad_sch]
2026-04-07 Ref LEDs added
    For 3.3V & 5V & ...
    Added for easy testing, LEDs running 2-3 mA each
    [VCUinvertor.kicad_pcb, VCUinvertor.kicad_sch]
2026-04-08 DAC1 - 3D model added
    [VCUinvertor.kicad_pcb, VCUinvertor.kicad_sch]
2026-04-24 Corrections on UART01/02
    [VCUinvertor.kicad_pcb, VCUinvertor.kicad_sch]
2026-04-26 Board - resized + Hole corrections
    [VCUinvertor.kicad_pcb, VCUinvertor.kicad_sch]
2026-04-27 INV wires displacement change
    Some connections were brought closer to their control pin
    [VCUinvertor.kicad_pcb]
2026-04-27 Corrections wiring Brake_light
    [VCUinvertor.kicad_pcb]
2026-04-28 Redid layout for CAN and DAC chips
    [VCUinvertor.kicad_pcb, VCUinvertor.kicad_sch]
2026-04-28 CleanUp after changes
    [VCUinvertor.kicad_pcb, VCUinvertor.kicad_sch]
2026-04-28 12V -> BAT+
    [VCUinvertor.kicad_pcb, VCUinvertor.kicad_sch]
2026-04-29 DAC - cap location correction
    [VCUinvertor.kicad_pcb]
2026-04-29 Redid reverse polarity protection
    [VCUinvertor.kicad_pcb]
2026-04-29 Supply GND small correction
    [VCUinvertor.kicad_pcb]
2026-04-30 Dorlington -> Relay for INV_OFF
    [VCUinvertor.kicad_pcb, VCUinvertor.kicad_sch]
2026-05-11 Relay NC to NO change
    [VCUinvertor.kicad_pcb, VCUinvertor.kicad_sch]
2026-05-11 Changes on NXPTPSOUT1&2
    1. Switch The switch to NO from NC --> From pin 2 to pin 4
    2.Move the connectors of the TPS OUT1 & 2
    [VCUinvertor.kicad_pcb, VCUinvertor.kicad_sch]
2026-05-11 Error corrections - Done
    [VCUinvertor.kicad_pcb]
2026-05-13 Small drawing correction
    [VCUinvertor.kicad_pcb]
2026-05-14 STEP file added
    [Shield_INV.step]
2026-05-18 MOS pulldown + missing INV pins added
    [VCUinvertor-B_Cu.gbl, VCUinvertor-B_Mask.gbs, VCUinvertor-B_Paste.gbp, VCUinvertor-B_Silkscreen.gbo, VCUinvertor-Edge_Cuts.gm1, VCUinvertor-F_Cu.gtl, VCUinvertor-F_Mask.gts, VCUinvertor-F_Paste.gtp]
2026-05-19 Wire labels correction
    [VCUinvertor.kicad_pcb, VCUinvertor.kicad_sch]
2026-05-26 Revision author added
    [VCUinvertor.kicad_sch]
2026-06-01 Corrections + PUMP&FAN circuit 0.1
    [Design1.ms14, VCUinvertor.kicad_pcb, VCUinvertor.kicad_sch]
2026-06-01 PCB Layout with FAN&PUMP MOS - Done
    [VCUinvertor.kicad_pcb, VCUinvertor.kicad_sch]
2026-06-03 Hole_mounting displacement correction
    [VCUinvertor.kicad_pcb]
2026-06-04 INV pinout+ layout changes - Done
    [Shield_INV_FAN_PUMP.step, Shield_INV_NO_FAN.step, VCUinvertor.kicad_pcb, VCUinvertor.kicad_sch]
2026-06-04 Board silkscreen corrections for visibility
    [VCUinvertor.kicad_pcb, VCUinvertor.kicad_sch]
2026-06-05 FAN&PUMP pin change
    [VCUinvertor.kicad_pcb, VCUinvertor.kicad_sch]
2026-06-06 Pin - GND assignment
    [BOM1.0(expired).csv, INV_FAN_2.0.step, VCUinvertor.kicad_pcb, VCUinvertor.kicad_sch]
2026-06-07 Mounting Holes + Relay Flyback added
    [VCUinvertor.kicad_pcb, VCUinvertor.kicad_sch]
2026-06-08 Connectors 2.0mm -> 2.5mm correction
    [VCUinvertor.kicad_pcb, VCUinvertor.kicad_sch]
2026-06-10 FAN MOS correction D->S
    [FANPUMPctrl.ms14, VCUinvertor.kicad_pcb, VCUinvertor.kicad_sch]
2026-06-14 Gate Driver MOS added + layout done
    [FANPUMPctrl.ms14, VCUinvertor.kicad_pcb, VCUinvertor.kicad_sch]
2026-06-14 CAN_IN + CAN_OUT added
    [VCUinvertor.kicad_pcb, VCUinvertor.kicad_sch]
2026-06-17 Prototype tested for FAN control
2026-06-20 TEMP/PRESSURE ctrl schematic - proto
    [Relay+BJT.ms14, S32K312MINI.kicad_pcb, VCUinvertor.kicad_sch]
2026-06-21 CAN: TJA1448 Footprint correction
    [NXP-TJA1448A_NXP.step, VCUinvertor.kicad_pcb, VCUinvertor.kicad_sch]
2026-06-21 Changed resistor footprints to 1206
    [VCUinvertor.kicad_pcb, VCUinvertor.kicad_sch]
2026-06-22 BOM - added
    [BOM_VCUinvertor.csv]
2026-06-23 Small optimisations, added jumper for CAN transciever VIO
    [VCUinvertor.kicad_pcb, VCUinvertor.kicad_sch]
2026-06-23 Thickened traces for fans, pumps and inverter supply
    [VCUinvertor.kicad_pcb]
2026-06-23 Redid connection for pump and fan signals
    [VCUinvertor.kicad_pcb, VCUinvertor.kicad_sch]
2026-06-23 Fixed violation for unconnected pin
    [VCUinvertor.kicad_pcb, VCUinvertor.kicad_sch]
2026-06-23 Updated BOM, two components left
    [BOM_VCUinvertor.csv]
2026-06-23 Changed the LED to be the same as VCU_Board
    [BOM_VCUinvertor.csv]
2026-06-23 Removed components that we have already from BOM
    [BOM_VCUinvertor.csv]
2026-06-25 Redid connections for pressure and temperature sensors
    [VCUinvertor.kicad_pcb]
2026-06-25 LDO supply wire correction
    [VCUinvertor.kicad_pcb]
2026-06-25 GBR - added
    [INV_FAN_2.0.step, Shield_INV_FAN_PUMP.step, Shield_INV_NO_FAN.step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]
2026-06-26 Remove custom GND for protection
    [VCUinvertor.kicad_pcb]
2026-06-29 GND plane small correction + new GBR - added + sent
    [VCUinvertor-B_Cu.gbl, VCUinvertor-B_Cu.gbr, VCUinvertor-B_Mask.gbr, VCUinvertor-B_Mask.gbs, VCUinvertor-B_Paste.gbp, VCUinvertor-B_Paste.gbr, VCUinvertor-B_Silkscreen.gbo, VCUinvertor-B_Silkscreen.gbr]
